dddy-tt/shuangshou/docs/current-pin-matrix.md

# 当前代码实际引脚表

这份表只描述当前工程里已经落实到 `.ioc` 和代码中的事实，不等同于设计文档的理想状态。

## 已基本一致

### ADC 柔性传感器

| 功能 | 当前工程 |
|---|---|
| 右手 5 路 ADC | `PA0..PA4` -> `ADC1_IN0..IN4` |
| 左手 5 路 ADC | `PA5..PA7`, `PB0`, `PB1` -> `ADC2_IN5..IN9` |
| DMA 方式 | `ADC1 DMA2_Stream0` 循环，`ADC2 DMA2_Stream2` 循环 |
| 依据 | `adc.c`、`.ioc` |

### 串口

| 功能 | 当前工程 |
|---|---|
| DFPlayer | `USART1` on `PA9 TX`, `PA10 RX` |
| 蓝牙 | `USART3` on `PC10 TX`, `PC11 RX` |
| DFPlayer DMA | `USART1_TX` -> `DMA2_Stream7` |
| 依据 | `usart.c`、`.ioc` |

### 软 I2C

| 总线 | 当前工程 |
|---|---|
| SoftI2C_1 | `PB6 SCL`, `PB7 SDA` |
| SoftI2C_2 | `PB8 SCL`, `PB9 SDA` |
| SoftI2C_3 | `PC6 SCL`, `PC7 SDA` |
| 依据 | `soft_i2c.h`、`.ioc` |

### 调度时钟

| 功能 | 当前工程 |
|---|---|
| 系统调度 tick | `TIM3` 1ms 中断 |
| 依据 | `main.c`、`.ioc` |

## 当前代码与设计文档有差异

### 振动电机 PWM

当前工程实际情况：
- `.ioc` 只配置了 `TIM4_CH1` 和 `TIM4_CH2`
- 引脚是 `PD12` 和 `PD13`
- `vibrator.c` 也只启动了 2 个通道

设计资料常见写法：
- `TIM4 CH1..CH4`
- `PE2..PE5`
- 右手/左手各两路

结论：
- 当前固件是 2 路振动实现
- 设计资料是 4 路振动设想
- 在没有真实硬件接线前，不建议直接改成 4 路

## 代码中存在，但 `.ioc` 未完整体现

### ESP-01S 软串口

当前代码实际情况：
- `soft_uart.h` 明确写了 `PE0 -> ESP-01S RX`
- 通过软件串口发送 ASCII `AT+MQTTPUB`

当前风险：
- `.ioc` 里没有看到 `PE0` 的明确配置项
- 更像是运行时软件自行配置，而不是完全靠 CubeMX 固化

结论：
- 这是代码层真实存在、工程图形配置未必完整表达的点
- 适合先记录，不适合现在强行改 `.ioc`

## 仍有历史遗留

这些不是引脚错误，但会误导后续协作：

1. `soft_i2c` 注释里还写着 `MPU6050`
2. 现在实际 IMU 驱动是 `JY61P`
3. 多处中文注释存在乱码

## 使用规则

1. 讨论当前代码用什么引脚时，优先以本表和 `.ioc` 为准。
2. 讨论设计原计划应该接什么引脚时，单独引用设计文档，不要混在一起。
3. 如果要改引脚，必须先回答 3 个问题：
   - 是当前代码事实，还是设计目标
   - 改 `.ioc` 还是改运行时代码
   - 有没有真实硬件连接作为依据
