dddy-tt/shuangshou/docs/EXEC_PLAN.md

# 双手手势项目执行计划

## 阶段 1：基础工程
- [ ] 检查 CubeMX 引脚和时钟配置
- [ ] 检查 ADC1、ADC2 和 DMA
- [ ] 检查 USART3
- [ ] 检查 I2C1
- [ ] 检查 TIM4 PWM
- [ ] 完成基础工程编译

## 阶段 2：STM32 驱动
- [ ] 双 ADC DMA 采集
- [ ] FLEX 滤波和校准
- [ ] JY61P I2C 驱动
- [ ] 蓝牙发送与接收
- [ ] 蜂鸣器控制
- [ ] 错误处理和日志

## 阶段 3：通信协议
- [ ] 定义数据帧
- [ ] 定义校验方式
- [ ] 定义命令和应答
- [ ] 编写协议解析测试
- [ ] 更新 docs/protocol.md

## 阶段 4：微信小程序
- [ ] 页面框架
- [ ] 蓝牙搜索和连接
- [ ] 数据接收和分包
- [ ] 手指弯曲数据显示
- [ ] 姿态数据显示
- [ ] 控制命令发送
- [ ] 异常状态提示

## 阶段 5：联调
- [ ] 固件模拟数据测试
- [ ] 小程序协议解析测试
- [ ] 真机蓝牙联调
- [ ] 传感器校准
- [ ] 完整验收文档
