dddy-tt/shuangshou/docs/作品报告待补充信息清单.md

# 作品报告待补充信息清单

## 1. 封面与参赛信息

- 参赛学校名称
- 队伍名称
- 队员姓名与分工
- 指导老师姓名
- 联系方式（如果模板要求）

## 2. 作品正式题目确认

- 当前已按“基于 STM32F407ZGT6 的双手智能手语交互手套系统”填写
- 如果你想用更正式的比赛题目，请给出最终版名称

## 3. 图片与图表素材

- 系统总体框图
- 手套整体实物图
- 主控板与传感器接线图
- 蓝牙模块、ESP-01S、继电器连接图
- Web Dashboard 截图
- Sensor Monitor 截图
- 自定义手势训练界面截图
- 家电远控演示截图

## 4. 机械结构信息

- 手套材质、固定方式、线缆收纳方式
- 是否有外壳、腰挂盒、桌面演示盒等结构件
- 是否有尺寸、重量、佩戴方式等可量化描述

## 5. 实测性能数据

- 手势识别准确率或命中率
- 蓝牙传输稳定距离
- 页面刷新或数据更新周期
- 继电器响应时间
- 连续运行时长或供电续航
- 校准耗时、训练耗时等可量化数据

## 6. 当前硬件完成度确认

- JY61P 是否已经切换到 I2C 模式并成功联调
- MAX30102 是否已经读取到有效数据
- JDY-33 是否已经采购并替换到位
- DFPlayer 是否已经完成实际播报验证
- 振动反馈是否已经实际接入

## 7. 参考文献

- 论文、产品手册、芯片手册、比赛参考资料等
- 当前文档的“参考文献”部分暂未填写

## 8. 心得体会个性化内容

- 当前心得体会已按项目推进过程写成通用版
- 如果你希望更贴近你个人经历，可以补充：
- 你负责的主要部分
- 你遇到的最难问题
- 你学到的最关键经验
- 你对比赛作品改进方向的真实想法
