dddy-tt/shuangshou/(commit log)

2026-09-24 feat: add stm32 virtual sensor test pipeline
2026-09-24 fix: avoid MicroLIB float scanf in test input
    [jy61p.h, main.c, test_input.c, test_input.h, test_input_test.c]
2026-09-24 chore: preserve real imu scaling in level2 fix
    [jy61p.h, test_input_test.c]
2026-09-24 fix: recover USART3 RX for Level 2 tests
    [bluetooth.c, bluetooth.h, main.c, run_virtual_sensor_test.py, test_virtual_sensor_runner.py, usart3_rx.c, usart3_rx.h, usart3_rx_test.c]
2026-09-24 fix: wait for virtual telemetry convergence after APPLY
    [run_virtual_sensor_test.py, test_virtual_sensor_runner.py]
2026-09-24 fix Level 2 virtual IMU corruption from undersized stack
    [main.c]
2026-09-25 fix: prevent false gesture matches from disabled fingers
2026-09-27 Fix real IMU motion capture validation and document hardware failures
    [test_real_imu.py, test_real_imu_health.py]
2026-09-27 test: normalize Level 4A motion I2C errors
    [test_real_imu.py, test_real_imu_health.py]
