dddy-tt/shuangshou/(notices)

Notices in the files:
firmware/stm32f407/Core/Src/adc.c:
Copyright (c) 2026 STMicroelectronics.
All rights reserved.
This software is licensed under terms that can be found in the LICENSE file
